spoobee/Energy_Meter/HW/Energy_Meter.kicad_pcb

## KiCad design HW/Energy_Meter.kicad_pcb (2020-12-23)

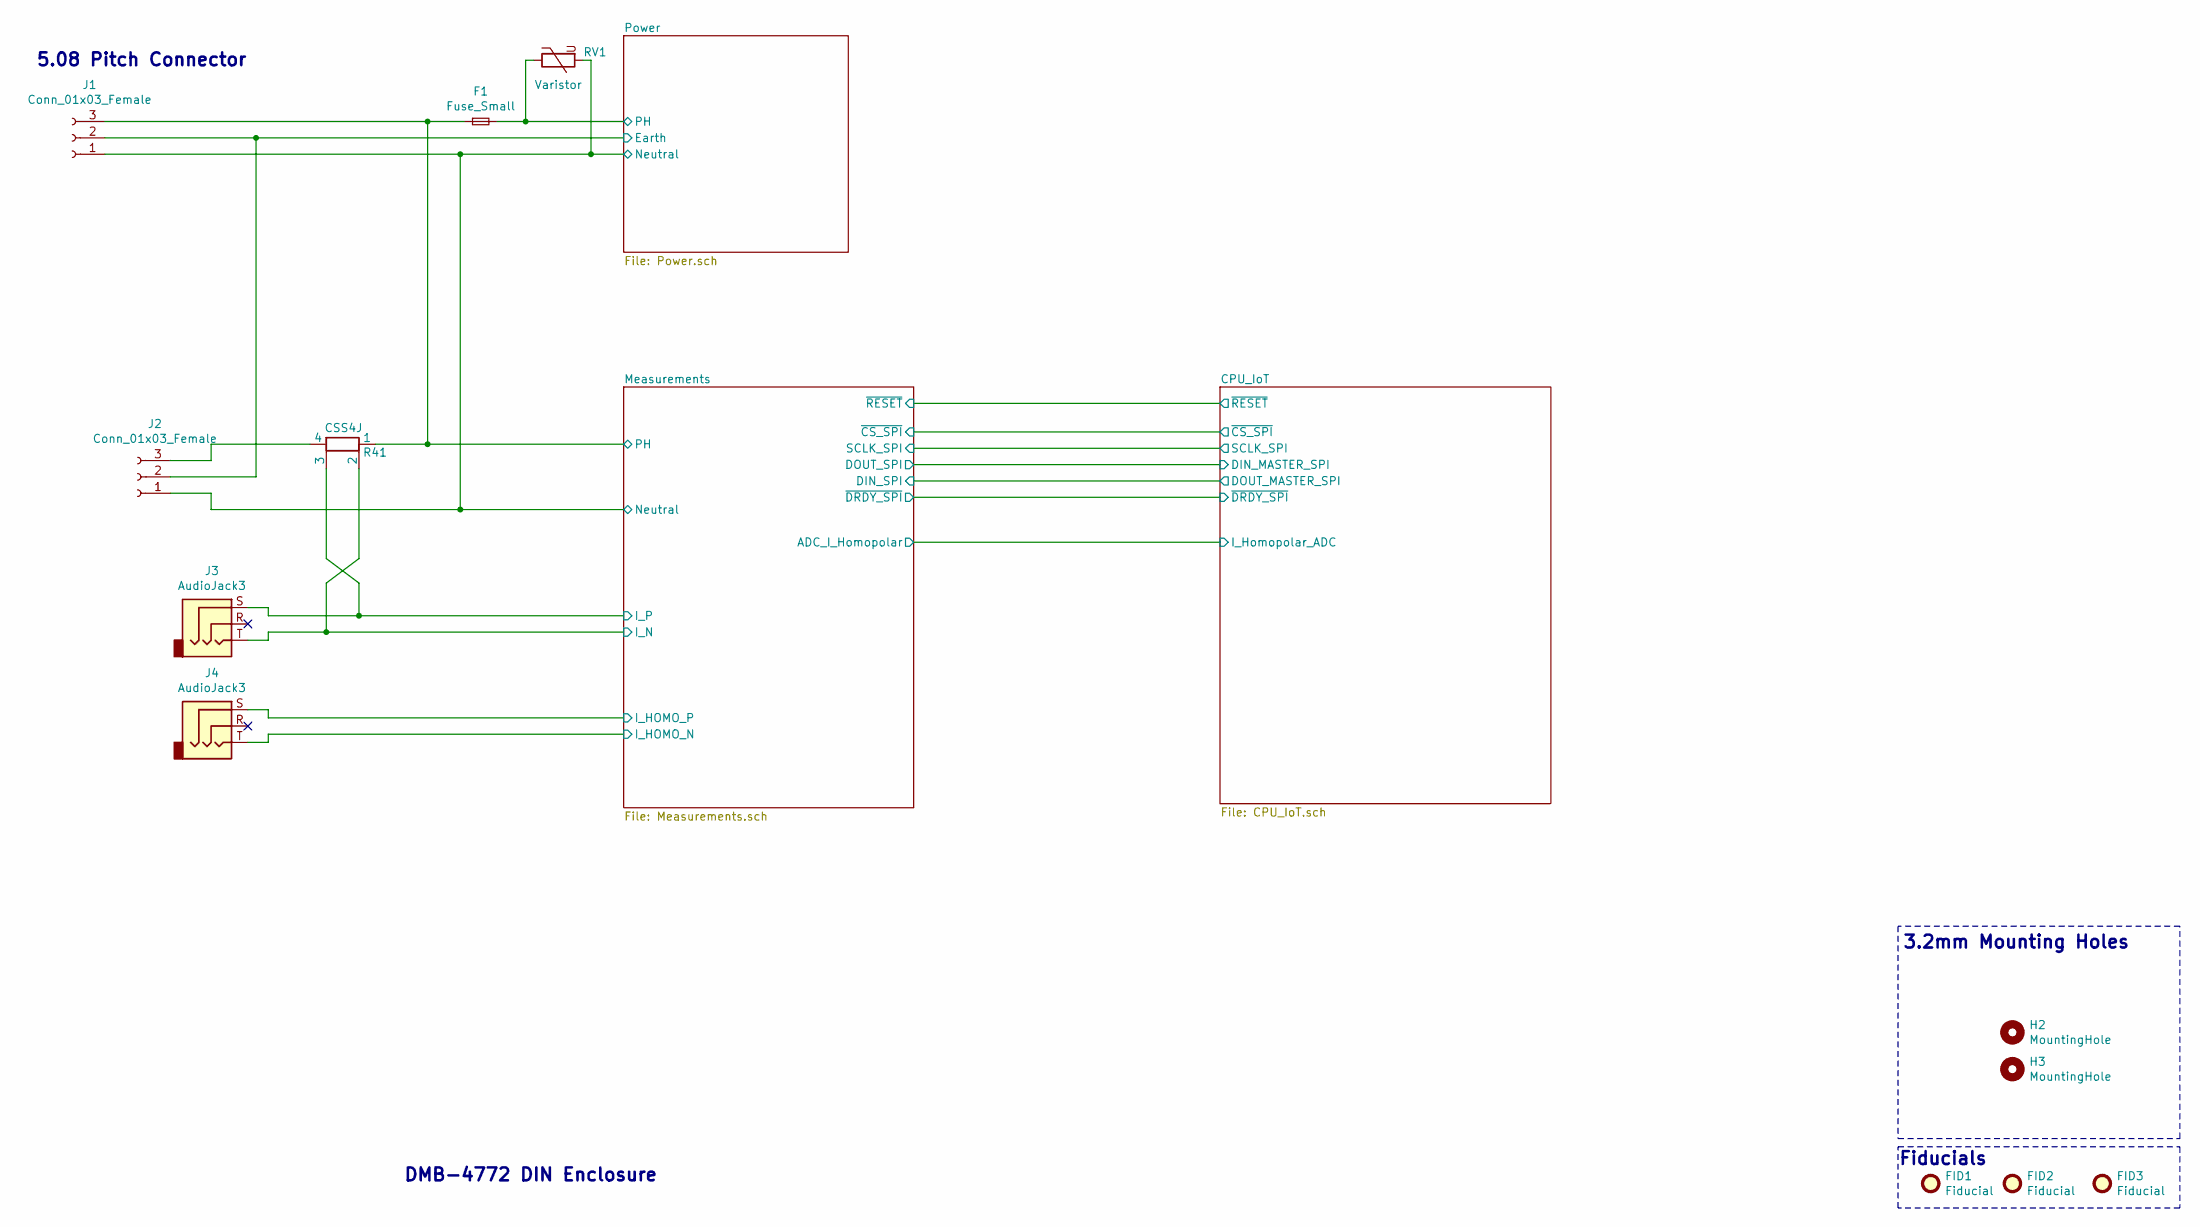
[picture p1: schematic Energy_Meter.sch, Mains Energy Meter]

Parts:
F1: Fuse_Small; Fuse_2920_7451Metric_Pad2.10x5.45mm_HandSolder
FID1, FID2, FID3: Fiducial; Fiducial_1mm_Mask2mm
H2, H3: MountingHole; MountingHole_3.2mm_M3_DIN965
J1, J2: Conn_01x03_Female; PhoenixContact_MCV_1,5_3-G-5.08_1x03_P5.08mm_Vertical
J3: AudioJack3; Jack_3.5mm_CUI_SJ1-3533NG_Horizontal; Mouser Ref 490-SJ1-3533NG
J4: AudioJack3; Jack_3.5mm_CUI_SJ1-3533NG_Horizontal
R41: CSS4J; CSS4J-4026R-1L00F; Mouser Ref 652-CSS4J4026K5L00F
RV1: Varistor; RV_Disc_D15.5mm_W3.9mm_P7.5mm

Connections:
/Measurements/I_HOMO_N: J4.T; also elsewhere on the board
/Measurements/I_HOMO_P: J4.S; also elsewhere on the board
/Measurements/I_N: J3.T, R41.2; also elsewhere on the board
/Measurements/I_P: J3.S, R41.3; also elsewhere on the board
/Measurements/Neutral: J1.1, J2.1, RV1.2; also elsewhere on the board
/Measurements/PH: F1.1, J1.3, R41.1; also elsewhere on the board
/Power/PH: F1.2, RV1.1; also elsewhere on the board
Earth: J1.2, J2.2
unnamed: J2.3, R41.4

Notes on the sheet:
Fiducials
5.08 Pitch Connector
3.2mm Mounting Holes
DMB-4772 DIN Enclosure

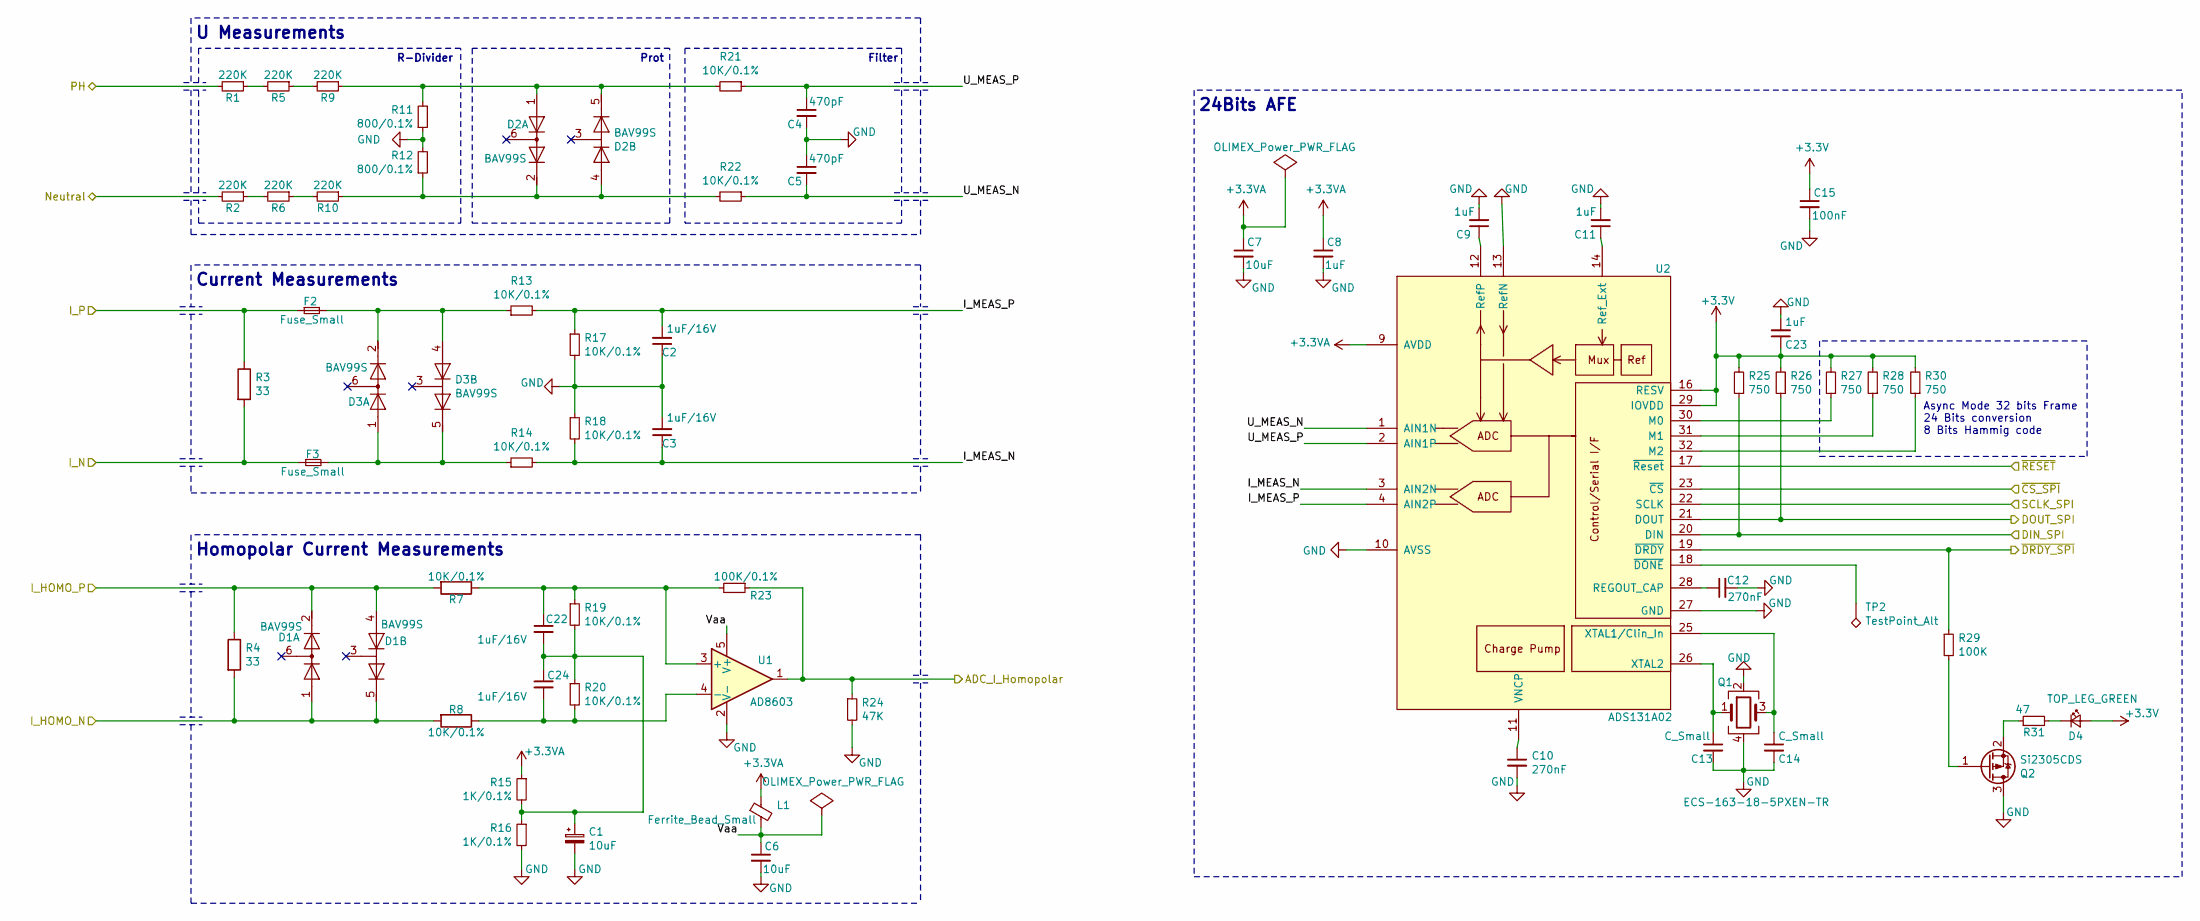
[picture p2: schematic Measurements.sch, Mains Energy Meter]

Parts:
C1, C6, C7: 10uF; C_1206_3216Metric_Pad1.42x1.75mm_HandSolder
C2, C3, C22, C24: 1uF/16V; C_0603_1608Metric_Pad1.05x0.95mm_HandSolder
C4, C5: 470pF; C_0603_1608Metric_Pad1.05x0.95mm_HandSolder
C8, C9, C11, C23: 1uF; C_1206_3216Metric_Pad1.42x1.75mm_HandSolder
C10, C12: 270nF; C_0603_1608Metric_Pad1.05x0.95mm_HandSolder
C13, C14: C_Small; C_0603_1608Metric_Pad1.05x0.95mm_HandSolder
C15: 100nF; C_0603_1608Metric_Pad1.05x0.95mm_HandSolder
D1, D2, D3: BAV99S; SOT-363_SC-70-6
D4: TOP_LEG_GREEN; LED_0603_1608Metric_Pad1.05x0.95mm_HandSolder; Mouser Ref 720-KTDELMS112A5167
F2, F3: Fuse_Small; Fuse_1210_3225Metric_Pad1.42x2.65mm_HandSolder
L1: Ferrite_Bead_Small; L_0603_1608Metric_Pad1.05x0.95mm_HandSolder
Q1: ECS-163-18-5PXEN-TR
Q2: Si2305CDS; SOT-23W_Handsoldering
R1, R2, R5, R6, R9, R10: 220K; R_1206_3216Metric_Pad1.42x1.75mm_HandSolder
R3, R4: 33; R_1206_3216Metric_Pad1.42x1.75mm_HandSolder
R7, R8, R13, R14, R17, R18, R19, R20, R21, R22: 10K/0.1%; R_0603_1608Metric_Pad1.05x0.95mm_HandSolder
R11, R12: 800/0.1%; R_1206_3216Metric_Pad1.42x1.75mm_HandSolder
R15, R16: 1K/0.1%; R_0603_1608Metric_Pad1.05x0.95mm_HandSolder
R23: 100K/0.1%; R_0603_1608Metric_Pad1.05x0.95mm_HandSolder
R24: 47K; R_0603_1608Metric_Pad1.05x0.95mm_HandSolder
R25, R26, R27, R28, R30: 750; R_0603_1608Metric_Pad1.05x0.95mm_HandSolder
R29: 100K; R_0603_1608Metric_Pad1.05x0.95mm_HandSolder
R31: 47; R_0603_1608Metric_Pad1.05x0.95mm_HandSolder
TP2: TestPoint_Alt; TestPoint_Pad_2.0x2.0mm
U1: AD8603; TSOT-23-5_HandSoldering
U2: ADS131A02; LQFP-32_5x5mm_P0.5mm

Connections:
+3.3VA: C7.1, C8.1, L1.1, R15.1, U2.9 (AVDD); also elsewhere on the board
+3V3: C15.1, C23.1, D4.2 (A), R25.2, R26.2, R27.2, R28.2, R30.2, U2.15 (IOVDD), U2.16 (RESV), U2.29 (IOVDD); also elsewhere on the board
/CPU_IoT/DIN_MASTER_SPI: R26.1, U2.21 (DOUT); also elsewhere on the board
/CPU_IoT/SCLK_SPI: U2.22 (SCLK); also elsewhere on the board
/CPU_IoT/~CS_SPI: U2.23 (~CS); also elsewhere on the board
/CPU_IoT/~DRDY_SPI: R29.1, U2.19 (~DRDY); also elsewhere on the board
/CPU_IoT/~RESET: U2.17 (~Reset); also elsewhere on the board
/Measurements/ADC_I_Homopolar: R23.1, R24.1, U1.1; also elsewhere on the board
/Measurements/DIN_SPI: R25.1, U2.20 (DIN); also elsewhere on the board
/Measurements/I_HOMO_N: D1.1 (A1), D1.5 (K4), R4.2, R8.2; also elsewhere on the board
/Measurements/I_HOMO_P: D1.2 (K2), D1.4 (A3), R4.1, R7.2; also elsewhere on the board
/Measurements/I_MEAS_N: C3.1, R14.2, R18.2, U2.3 (AIN2N)
/Measurements/I_MEAS_P: C2.2, R13.2, R17.1, U2.4 (AIN2P)
/Measurements/I_N: F3.1, R3.2; also elsewhere on the board
/Measurements/I_P: F2.1, R3.1; also elsewhere on the board
/Measurements/Neutral: R2.2; also elsewhere on the board
/Measurements/PH: R1.2; also elsewhere on the board
/Measurements/U_MEAS_N: C5.2, R22.1, U2.1 (AIN1N)
/Measurements/U_MEAS_P: C4.1, R21.1, U2.2 (AIN1P)
/Measurements/Vaa: C6.1, L1.2, U1.5 (V+)
GND: C1.2, C2.1, C3.2, C4.2, C5.1, C6.2, C7.2, C8.2, C9.2, C10.2, C11.2, C12.2, C13.2, C14.2, C15.2, C23.2, Q1.2, Q1.4, Q2.3 (D), R11.1, R12.2, R16.2, R17.2, R18.1, R24.2, U1.2 (V-), U2.10 (AVSS), U2.13 (RefN), U2.27 (GND); also elsewhere on the board
unnamed: C1.1, C22.2, C24.1, R15.2, R16.1, R19.2, R20.1
unnamed: C9.1, U2.12 (RefP)
unnamed: C10.1, U2.11 (VNCP)
unnamed: C11.1, U2.14 (Ref_Ext)
unnamed: C12.1, U2.28 (REGOUT_CAP)
unnamed: C13.1, Q1.1, U2.26 (XTAL2)
unnamed: C14.1, Q1.3, U2.25 (XTAL1/Clin_In)
unnamed: C22.1, R7.1, R19.1, R23.2, U1.3 (+)
unnamed: C24.2, R8.1, R20.2, U1.4 (-)
unnamed: D2.1 (A1), D2.5 (K4), R9.1, R11.2, R21.2
unnamed: D2.2 (K2), D2.4 (A3), R10.1, R12.1, R22.2
unnamed: D3.1 (A1), D3.5 (K4), F3.2, R14.1
unnamed: D3.2 (K2), D3.4 (A3), F2.2, R13.1
unnamed: D4.1 (K), R31.2
unnamed: Q2.1 (G), R29.2
unnamed: Q2.2 (S), R31.1
unnamed: R1.1, R5.2
unnamed: R2.1, R6.2
unnamed: R5.1, R9.2
unnamed: R6.1, R10.2
unnamed: R27.1, U2.30 (M0)
unnamed: R28.1, U2.31 (M1)
unnamed: R30.1, U2.32 (M2)
unnamed: TP2.1, U2.18 (~DONE)

Notes on the sheet:
Async Mode 32 bits Frame 24 Bits conversion 8 Bits Hammig code
R-Divider
Prot
Filter
Homopolar Current Measurements
Current Measurements
U Measurements
24Bits AFE

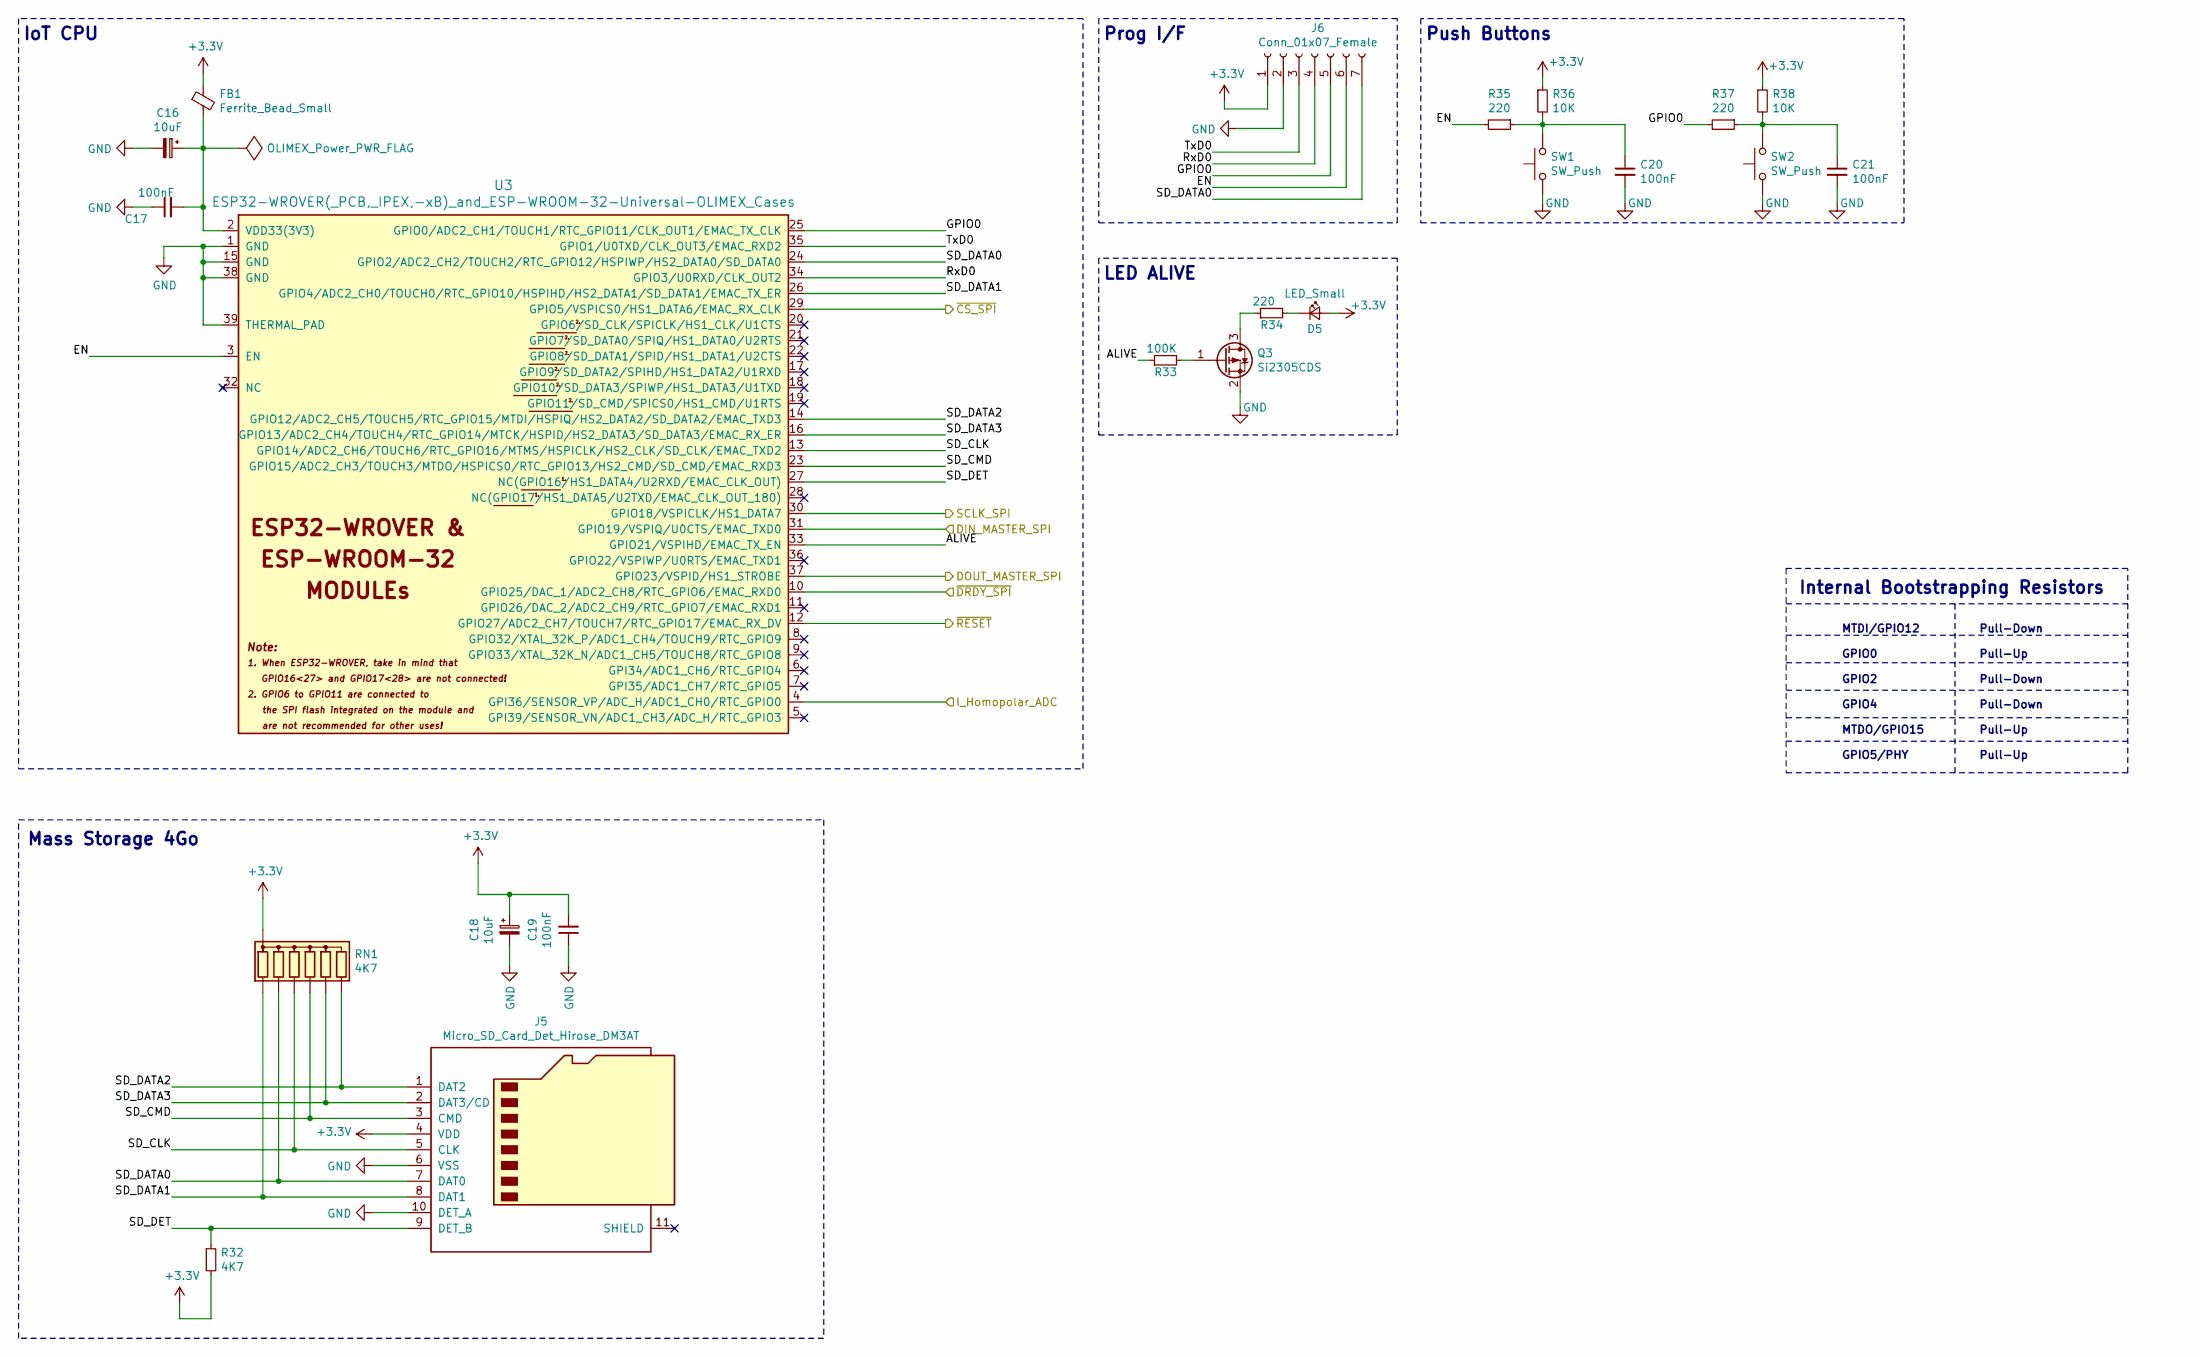
[picture p3: schematic CPU_IoT.sch, Mains Energy Meter]

Parts:
C16, C18: 10uF; C_1206_3216Metric_Pad1.42x1.75mm_HandSolder
C17, C19, C20, C21: 100nF; C_0603_1608Metric_Pad1.05x0.95mm_HandSolder
D5: LED_Small; LED_0603_1608Metric_Pad1.05x0.95mm_HandSolder
FB1: Ferrite_Bead_Small; L_0603_1608Metric_Pad1.05x0.95mm_HandSolder
J5: Micro_SD_Card_Det_Hirose_DM3AT; microSD_HC_Hirose_DM3AT-SF-PEJM5
J6: Conn_01x07_Female; PinHeader_1x07_P2.54mm_Vertical
Q3: Si2305CDS; SOT-23W_Handsoldering
R32: 4K7; R_0603_1608Metric_Pad1.05x0.95mm_HandSolder
R33: 100K; R_0603_1608Metric_Pad1.05x0.95mm_HandSolder
R34, R35, R37: 220; R_0603_1608Metric_Pad1.05x0.95mm_HandSolder
R36, R38: 10K; R_0603_1608Metric_Pad1.05x0.95mm_HandSolder
RN1: 4K7; R_Array_SIP7; Mouser Ref 652-4607X-1LF-2.2K
SW1, SW2: SW_Push; SW_Push_1P1T_NO_CK_KMR2
U3: ESP32-WROVER(_PCB,_IPEX,-xB)_and_ESP-WROOM-32-Uni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; ESP-WROOM-32_MODULE

Connections:
+3V3: C18.1, C19.2, D5.2 (A), FB1.1, J5.4 (VDD), J6.1, R32.2, R36.1, R38.1, RN1.1 (common); also elsewhere on the board
/CPU_IoT/ALIVE: R33.1, U3.33 (GPIO21/VSPIHD/EMAC_TX_EN)
/CPU_IoT/DIN_MASTER_SPI: U3.31 (GPIO19/VSPIQ/U0CTS/EMAC_TXD0); also elsewhere on the board
/CPU_IoT/EN: J6.6, R35.2, U3.3 (EN)
/CPU_IoT/GPIO0: J6.5, R37.2, U3.25 (GPIO0/ADC2_CH1/TOUCH1/RTC_GPIO11/CLK_OU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)
/CPU_IoT/RxD0: J6.4, U3.34 (GPIO3/U0RXD/CLK_OUT2)
/CPU_IoT/SCLK_SPI: U3.30 (GPIO18/VSPICLK/HS1_DATA7); also elsewhere on the board
/CPU_IoT/SD_CLK: J5.5 (CLK), RN1.4 (R3), U3.13 (GPIO14/ADC2_CH6/TOUCH6/RTC_GPIO16/MTMS/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)
/CPU_IoT/SD_CMD: J5.3 (CMD), RN1.5 (R4), U3.23 (GPIO15/ADC2_CH3/TOUCH3/MTDO/HSPICS0/RTC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)
/CPU_IoT/SD_DATA0: J5.7 (DAT0), J6.7, RN1.3 (R2), U3.24 (GPIO2/ADC2_CH2/TOUCH2/RTC_GPIO12/HSPIWP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)
/CPU_IoT/SD_DATA1: J5.8 (DAT1), RN1.2 (R1), U3.26 (GPIO4/ADC2_CH0/TOUCH0/RTC_GPIO10/HSPIHD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)
/CPU_IoT/SD_DATA2: J5.1 (DAT2), RN1.7 (R6), U3.14 (GPIO12/ADC2_CH5/TOUCH5/RTC_GPIO15/MTDI/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)
/CPU_IoT/SD_DATA3: J5.2 (DAT3/CD), RN1.6 (R5), U3.16 (GPIO13/ADC2_CH4/TOUCH4/RTC_GPIO14/MTCK/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)
/CPU_IoT/SD_DET: J5.9 (DET_B), R32.1, U3.27 (NC(GPIO16/HS1_DATA4/U2RXD/EMAC_CLK_OUT))
/CPU_IoT/TxD0: J6.3, U3.35 (GPIO1/U0TXD/CLK_OUT3/EMAC_RXD2)
/CPU_IoT/~CS_SPI: U3.29 (GPIO5/VSPICS0/HS1_DATA6/EMAC_RX_CLK); also elsewhere on the board
/CPU_IoT/~DRDY_SPI: U3.10 (GPIO25/DAC_1/ADC2_CH8/RTC_GPIO6/EMAC_RX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); also elsewhere on the board
/CPU_IoT/~RESET: U3.12 (GPIO27/ADC2_CH7/TOUCH7/RTC_GPIO17/EMAC_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); also elsewhere on the board
/Measurements/ADC_I_Homopolar: U3.4 (GPI36/SENSOR_VP/ADC_H/ADC1_CH0/RTC_GPIO0); also elsewhere on the board
/Measurements/DIN_SPI: U3.37 (GPIO23/VSPID/HS1_STROBE); also elsewhere on the board
GND: C16.2, C17.1, C18.2, C19.1, C20.2, C21.2, J5.6 (VSS), J5.10 (DET_A), J6.2, Q3.2 (S), SW1.1, SW2.1, U3.1 (GND), U3.15 (GND), U3.38 (GND), U3.39 (THERMAL_PAD); also elsewhere on the board
unnamed: C16.1, C17.2, FB1.2, U3.2 (VDD33(3V3))
unnamed: C20.1, R35.1, R36.2, SW1.2
unnamed: C21.1, R37.1, R38.2, SW2.2
unnamed: D5.1 (K), R34.2
unnamed: Q3.1 (G), R33.2
unnamed: Q3.3 (D), R34.1

Notes on the sheet:
Internal Bootstrapping Resistors
MTDI/GPIO12 GPIO0 GPIO2 GPIO4 MTDO/GPIO15 GPIO5/PHY
Pull-Down Pull-Up Pull-Down Pull-Down Pull-Up Pull-Up
Mass Storage 4Go
IoT CPU
Prog I/F
Push Buttons
LED ALIVE

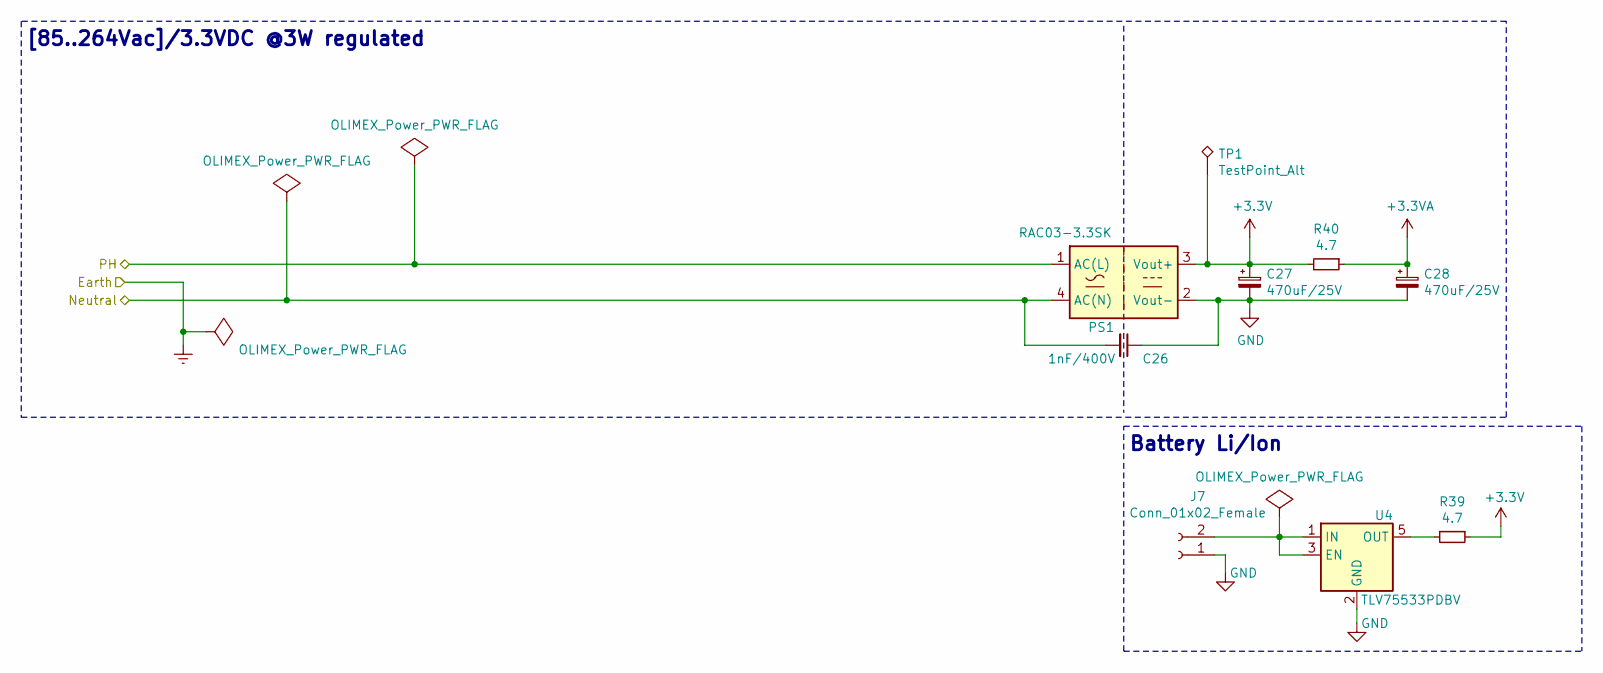
[picture p4: schematic Power.sch, Mains Energy Meter]

Parts:
C26: 1nF/400V; C_Rect_L11.0mm_W2.8mm_P10.00mm_MKT
C27, C28: 470uF/25V; CP_Elec_10x10
J7: Conn_01x02_Female; PhoenixContact_MCV_1,5_2-G-5.08_1x02_P5.08mm_Vertical
PS1: RAC03-3.3SK; RAC03-XXSGB; Mouser Ref 919-RAC03-3.3SK
R39, R40: 4.7; R_0603_1608Metric_Pad1.05x0.95mm_HandSolder
TP1: TestPoint_Alt; TestPoint_Pad_2.0x2.0mm
U4: TLV75533PDBV; SOT-23-5_HandSoldering

Connections:
+3.3VA: C28.1, R40.1; also elsewhere on the board
+3V3: C27.1, PS1.3 (Vout+), R39.1, R40.2, TP1.1; also elsewhere on the board
/Measurements/Neutral: C26.2, PS1.4 (AC(N)); also elsewhere on the board
/Power/PH: PS1.1 (AC(L)); also elsewhere on the board
GND: C26.1, C27.2, C28.2, J7.1, PS1.2 (Vout-), U4.2 (GND); also elsewhere on the board
unnamed: J7.2, U4.1 (IN), U4.3 (EN)
unnamed: R39.2, U4.5 (OUT)

Notes on the sheet:
[85..264Vac]/3.3VDC @3W regulated
Battery Li/Ion

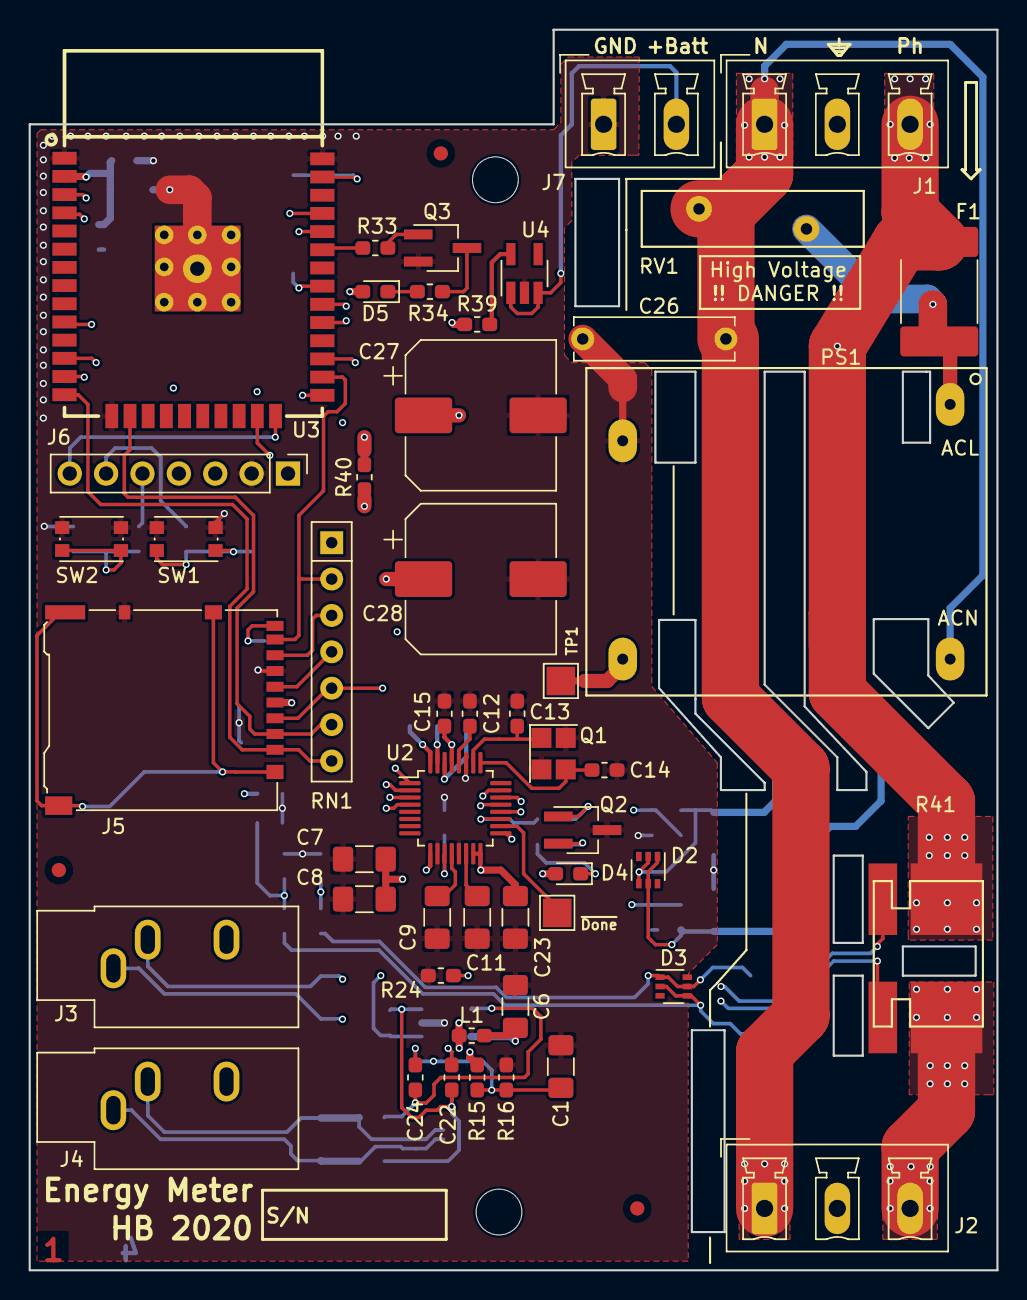
[picture p5: board Energy_Meter.kicad_pcb from above]

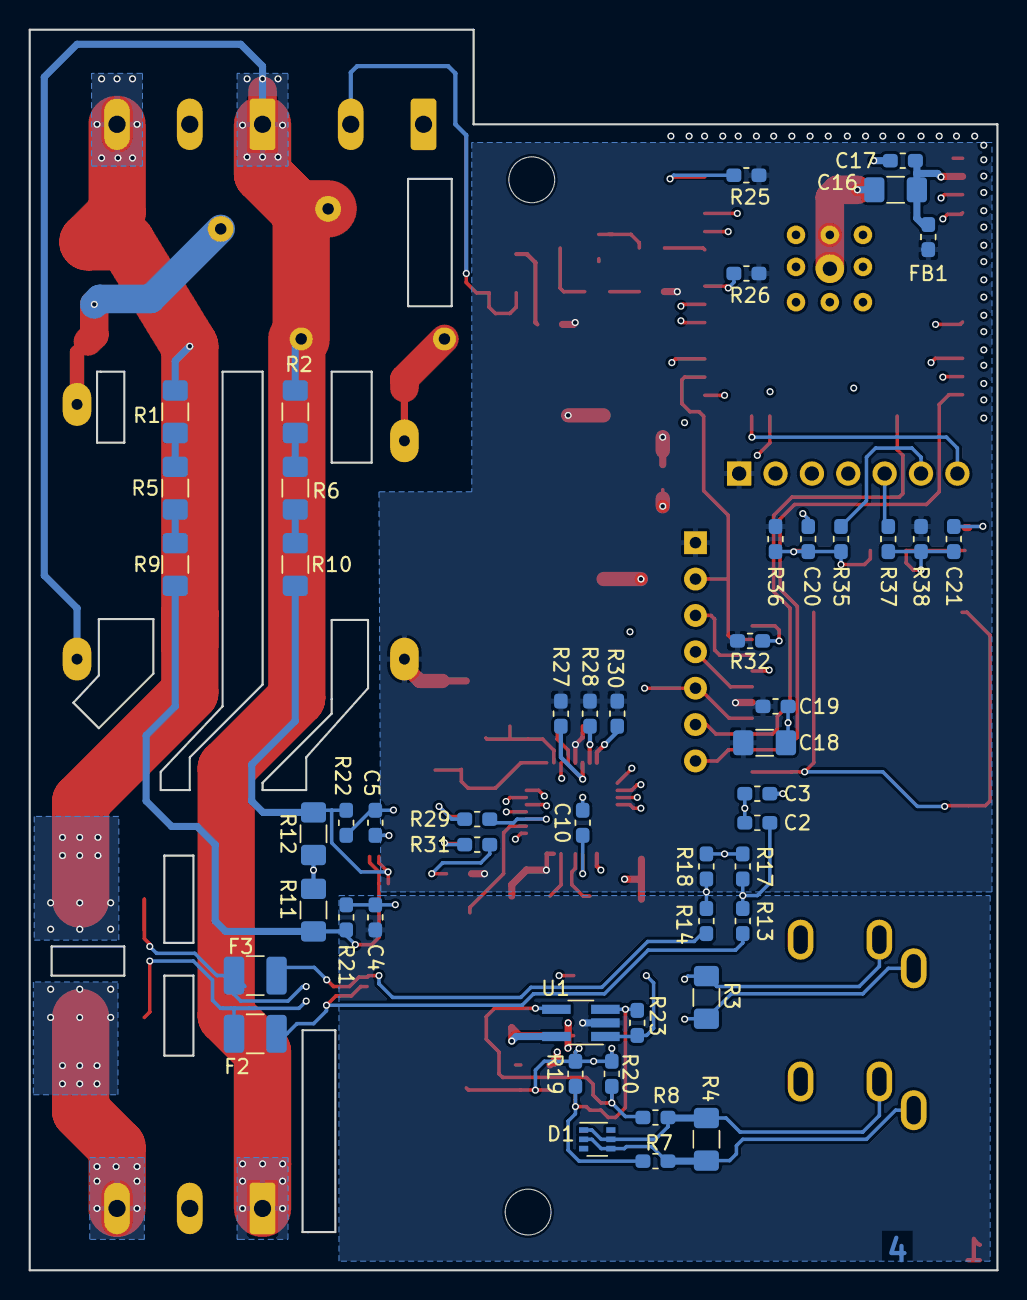
[picture p6: board Energy_Meter.kicad_pcb from below]

Board: 4 copper layers, 67.6 x 86.6 mm, 103 parts (49 on the bottom side), 67 nets.
